ibnhazem/VitalsMonitor2242/AlgorithmSketchNotebook.jpg

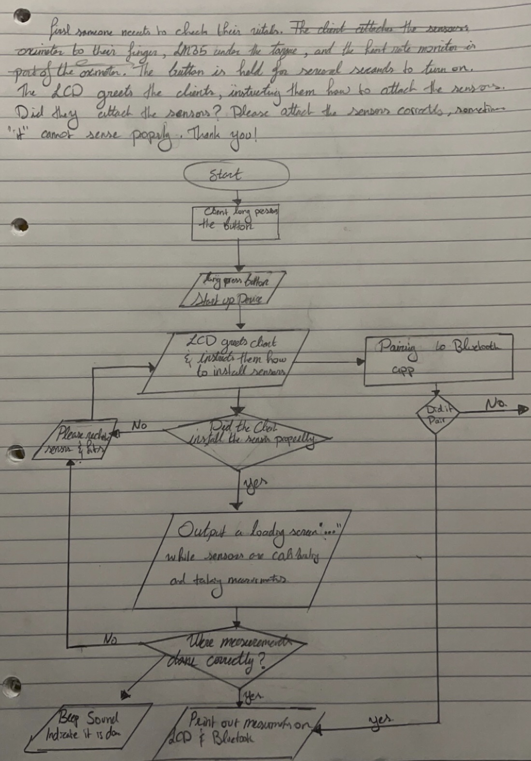
AlgorithmSketchNotebook.jpg
