ibnhazem/VitalsMonitor2242/BlockDiagramSketchNotebook.jpg

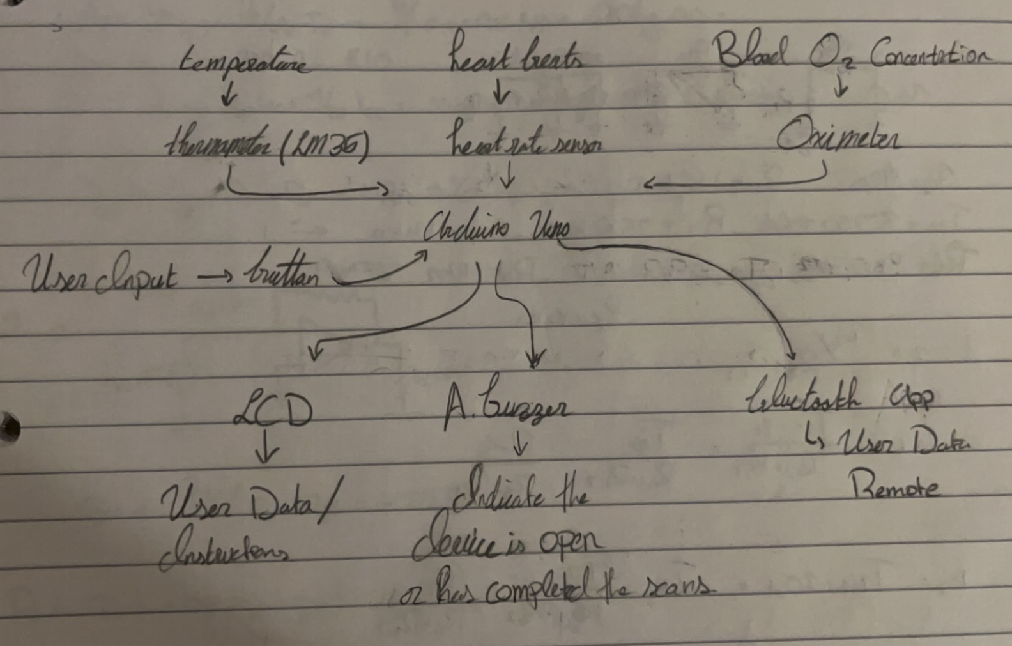
BlockDiagramSketchNotebook.jpg
