ibnhazem/VitalsMonitor2242/README.txt

Libraries used:
- Arduino-MAX30100-master
- MAX30100-1.0.0
- 019-LCD1602-I2C-library-master
- Arduino-LiquidCrystal-I2C-library-master
- LiquidCrystal_I2C-1.1.2
