ibnhazem/VitalsMonitor2242/AlgorithmIdeaSketch_1.jpg

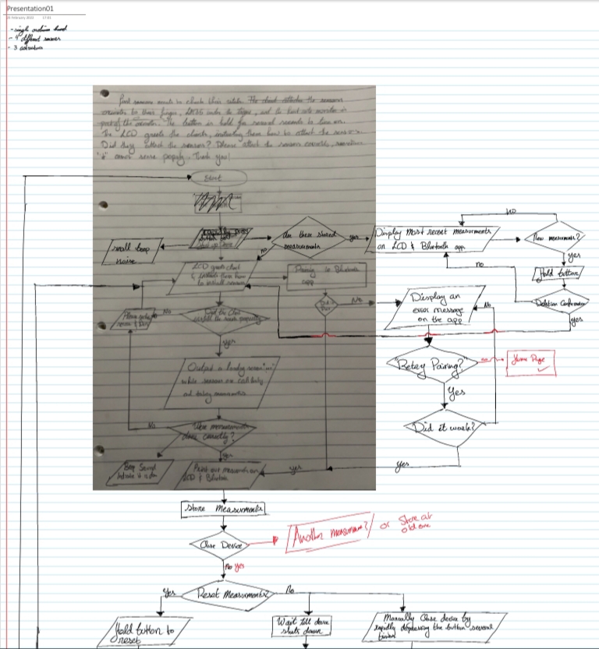
AlgorithmIdeaSketch_1.jpg
