ibnhazem/VitalsMonitor2242/AlgorithmIdeaSketch_2.jpg

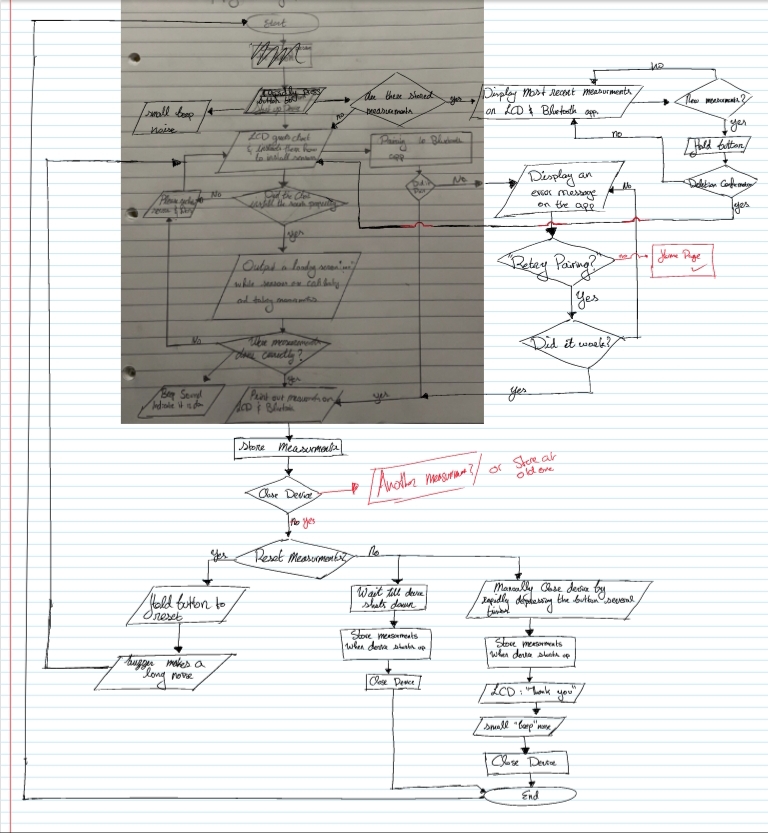
AlgorithmIdeaSketch_2.jpg
