ibnhazem/VitalsMonitor2242/CostAnalysis.xlsx

Component | Cost ($)
LM35 | $2.12
MAX30100 | $6.67
Button | $0.25
LCD | $9.93
Buzzer | $1.55
Bluetooth | $5.89
Arduino UNO R3 | $21.44
Total | $47.85
