ibnhazem/VitalsMonitor2242/2242_project_part_brd.sch

## EAGLE design 2242_project_part_brd.sch (2023-07-14)

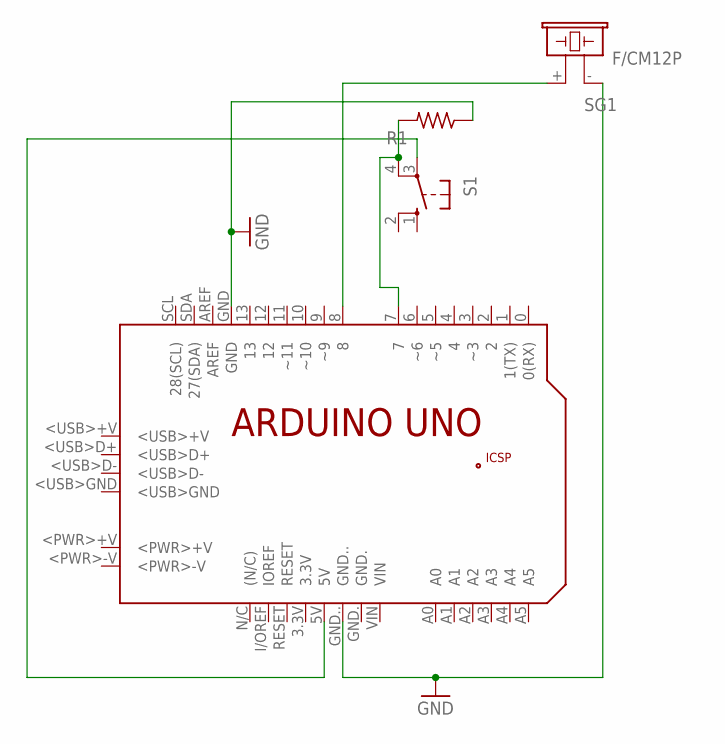
[picture p19: schematic 2242_project_part_brd.sch]

Parts:
PCB1: ARDUINO_UNO
R1: R-US_0204/2V; 0204V
S1: 10-XX; B3F-10XX
SG1: F/CM12P

Connections:
GND: PCB1.GND, PCB1.GND.., R1.1, SG1.- (2)
unnamed: PCB1.7, R1.2, S1.4 (P1)
unnamed: PCB1.8, SG1.+ (1)
unnamed: PCB1.5V, S1.3
