ibnhazem/VitalsMonitor2242/BluetoothcodeSerialMonitor/BluetoothcodeSerialMonitor.ino

#define ledPin 7
int state = 0;
const int BUTTON_PIN = 4; // Arduino pin connected to button's pin
const int BUZZER_PIN = 3; // Arduino pin connected to Buzzer's pin


void setup() {
  pinMode(ledPin, OUTPUT);
  digitalWrite(ledPin, LOW);
  Serial.begin(38400); // Default communication rate of the Bluetooth module
  Serial.begin(9600);                // initialize the PC serial monitor
  pinMode(BUTTON_PIN, INPUT_PULLUP); // set arduino pin to input pull-up mode
  pinMode(BUZZER_PIN, OUTPUT);       // set arduino pin to output mode
  
}

void loop() {
  int buttonState = digitalRead(BUTTON_PIN); // read new state

  if (buttonState == LOW) {
    Serial.println("The button is being pressed");
    digitalWrite(BUZZER_PIN, HIGH); // turn on
  }
  else
  if (buttonState == HIGH) {
    Serial.println("The button is unpressed");
    digitalWrite(BUZZER_PIN, LOW);  // turn off
  }
  

  
  if(Serial.available() > 0){ // Checks whether data is comming from the serial port
    state = Serial.read(); // Reads the data from the serial port }

 if (state == '0') {
  digitalWrite(ledPin, LOW); // Turn LED OFF
  Serial.println("LED: OFF"); // Send back, to the phone, the String "LED: ON"
  state = 0;
 }
 else if (state == '1') {
  digitalWrite(ledPin, HIGH);
  Serial.println("LED: ON");;
  state = 0;
 }
  }
}
