ibnhazem/VitalsMonitor2242/Pluse_Oximeter/Pluse_Oximeter.ino

#include <Wire.h>
#include "MAX30100_PulseOximeter.h"
#include <LiquidCrystal.h>
 
#define REPORTING_PERIOD_MS     1000
#define rs 9 
#include <LiquidCrystal_I2C.h>
#include <Wire.h>
#include "MAX30100_PulseOximeter.h"
// initialize the library with the numbers of the interface pins

LiquidCrystal_I2C lcd(0x27, 16, 2);
 
PulseOximeter pox;
uint32_t tsLastReport = 0;
 
void onBeatDetected()
{
    Serial.println("Beat!");
}
 
void setup()
{
    Serial.begin(9500);
    Serial.print("Initializing pulse oximeter..");
     if (!pox.begin()) {
        Serial.println("FAILED");
        for(;;);
    } else {
        Serial.println("SUCCESS");
    }
     pox.setIRLedCurrent(MAX30100_LED_CURR_7_6MA);
 
    // Register a callback for the beat detection
    pox.setOnBeatDetectedCallback(onBeatDetected);
   // set up the LCD's number of columns and rows: 
  lcd.begin();
  lcd.backlight();
  // Print a message to the LCD.
  lcd.print("Oximeter");
    // Initialize the PulseOximeter instance
    // Failures are generally due to an improper I2C wiring, missing power supply
    // or wrong target chip
    if (!pox.begin()) {
        Serial.println("FAILED");
        for(;;);
    } else {
        Serial.println("SUCCESS");
    }
     pox.setIRLedCurrent(MAX30100_LED_CURR_7_6MA);
 
    // Register a callback for the beat detection
    pox.setOnBeatDetectedCallback(onBeatDetected);
}
 
void loop()
{
  // Make sure to call update as fast as possible
    pox.update();
    if (millis() - tsLastReport > REPORTING_PERIOD_MS) {
        Serial.print("Heart rate:");
        Serial.print(pox.getHeartRate());
        Serial.print("bpm / SpO2:");
        Serial.print(pox.getSpO2());
        Serial.println("%");
 
        tsLastReport = millis();
    // Make sure to call update as fast as possible
    pox.update();
    if (millis() - tsLastReport > REPORTING_PERIOD_MS) {
 
 
        lcd.clear();
        lcd.setCursor(0,0);
        lcd.print("BPM: ");
        lcd.print(pox.getHeartRate());
        
        lcd.setCursor(0,1);
        lcd.print("SpO2: ");
        lcd.print(pox.getSpO2());
        lcd.print("%");
 
 
        tsLastReport = millis();
    }
    }
}
