ibnhazem/VitalsMonitor2242/somethingidkfrominternet/somethingidkfrominternet.ino

/*
Download Libraries:
https://www.electroniclinic.com/arduino-libraries-download-and-projects-they-are-used-in-project-codes/
*/
#include <Wire.h>
#include <SoftwareSerial.h>
#include <LiquidCrystal_I2C.h>
LiquidCrystal_I2C lcd(0x27,16,2);  //0x27 is the i2c address, while 16 = columns, and 2 = rows. 
#include "MAX30100_PulseOximeter.h"
SoftwareSerial blue(2,3); // bluetooth module connected here 
 
 
#define REPORTING_PERIOD_MS     1000
 
 
PulseOximeter pox;
uint32_t tsLastReport = 0;
 
void onBeatDetected()
{
    Serial.println("Beat!");
}
 
void setup()
{
    Serial.begin(9500);
    blue.begin(9600); 
    lcd.begin();                 //Init the LCD
  lcd.backlight();            //Activate backlight     
  lcd.home(); 
    Serial.print("Initializing pulse oximeter..");
  
 
    // Initialize the PulseOximeter instance
    // Failures are generally due to an improper I2C wiring, missing power supply
    // or wrong target chip
    if (!pox.begin()) {
        Serial.println("FAILED");
        for(;;);
    } else {
        Serial.println("SUCCESS");
    }
     pox.setIRLedCurrent(MAX30100_LED_CURR_7_6MA);
 
    // Register a callback for the beat detection
    pox.setOnBeatDetectedCallback(onBeatDetected);
 
  
}
 
void loop()
{
  Serial.println("what");
    // Make sure to call update as fast as possible
    pox.update();
    if (millis() - tsLastReport > REPORTING_PERIOD_MS) {
 
 
  // to android cell phone application
        blue.print("BPM: ");
        blue.print(pox.getHeartRate());
        //blue.println("\n");
        
        blue.print("    SpO2: ");
        blue.print(pox.getSpO2());
        blue.print("%");
        blue.println("\n");
        
// to 16x2 LCD
        lcd.clear();
        lcd.setCursor(0,0);
        lcd.print("BPM: ");
        lcd.print(pox.getHeartRate());
        
        lcd.setCursor(0,1);
        lcd.print("SpO2: ");
        lcd.print(pox.getSpO2());
        lcd.print("%");
 
        tsLastReport = millis();
        
    }
 
}
